machidyo/webcamera-holder/output/webcamera_holder.3mf

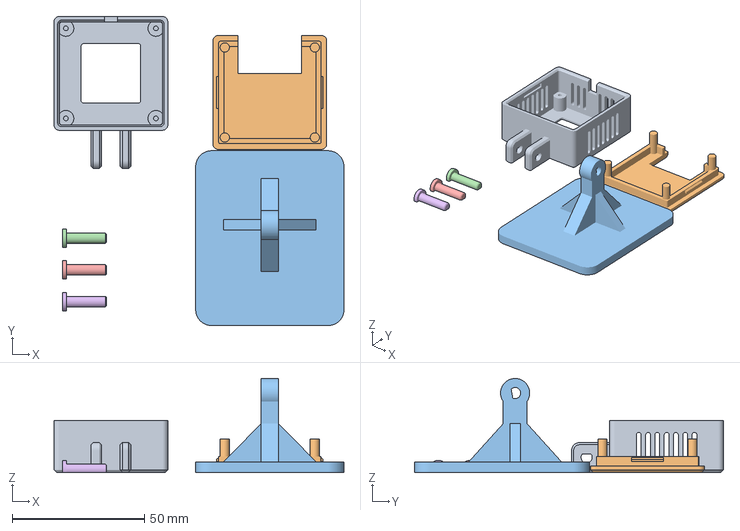
[picture p1: CAD file, 2026-11-09]
output/webcamera_holder.3mf
109.5 x 116.7 x 35.5 mm
