machidyo/webcamera-holder/output/cover.stl

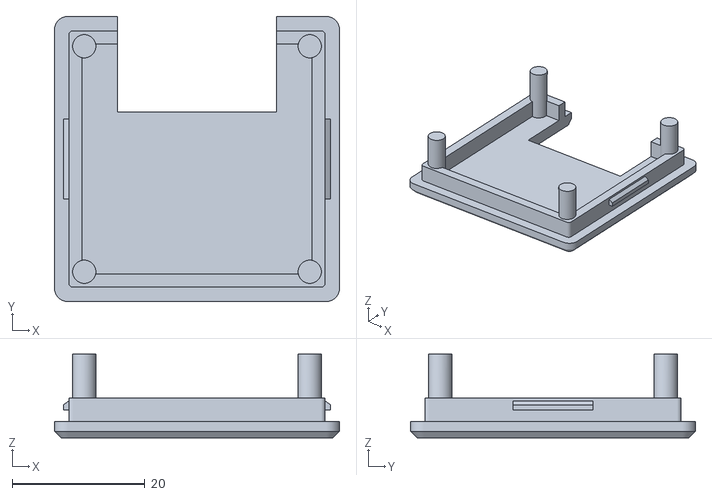
[picture p2: CAD file, 2026-11-09]
output/cover.stl
43.0 x 43.0 x 12.6
