machidyo/webcamera-holder/output/reprint_cover_pins.3mf

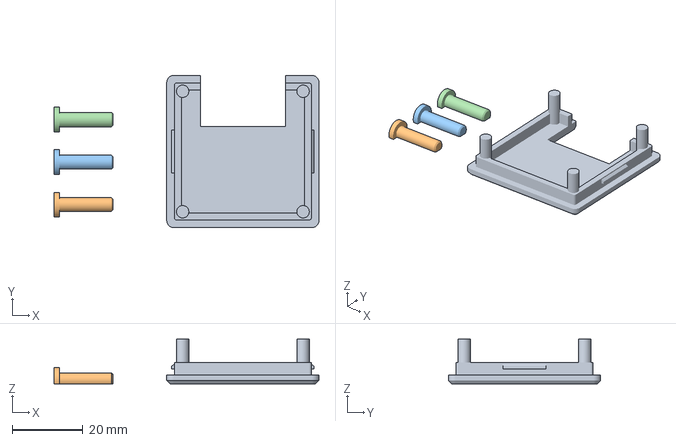
[picture p3: CAD file, 2026-11-09]
output/reprint_cover_pins.3mf
74.8 x 43.0 x 12.7 mm
