machidyo/webcamera-holder/output/stand.stl

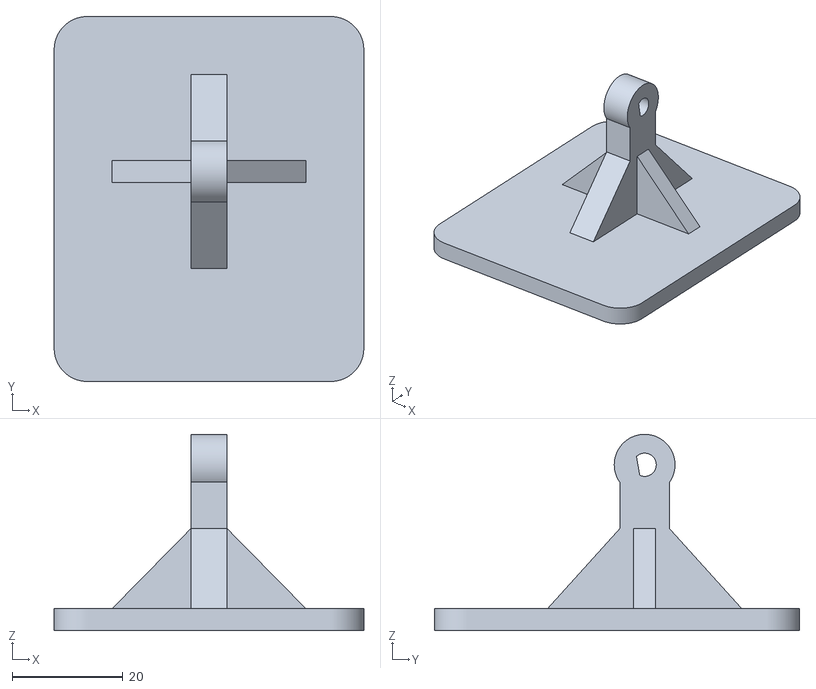
[picture p4: CAD file, 2026-11-09]
output/stand.stl
56.0 x 66.0 x 35.5
