machidyo/webcamera-holder/output/housing.stl

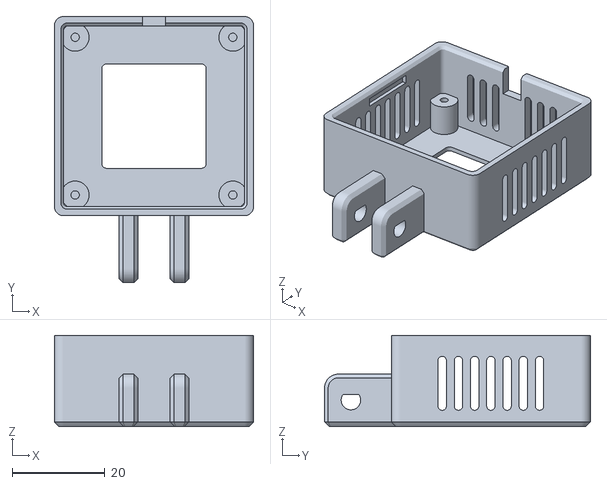
[picture p5: CAD file, 2026-10-15]
output/housing.stl
43.0 x 57.4 x 19.6
