machidyo/webcamera-holder/output/pin_4.0.stl

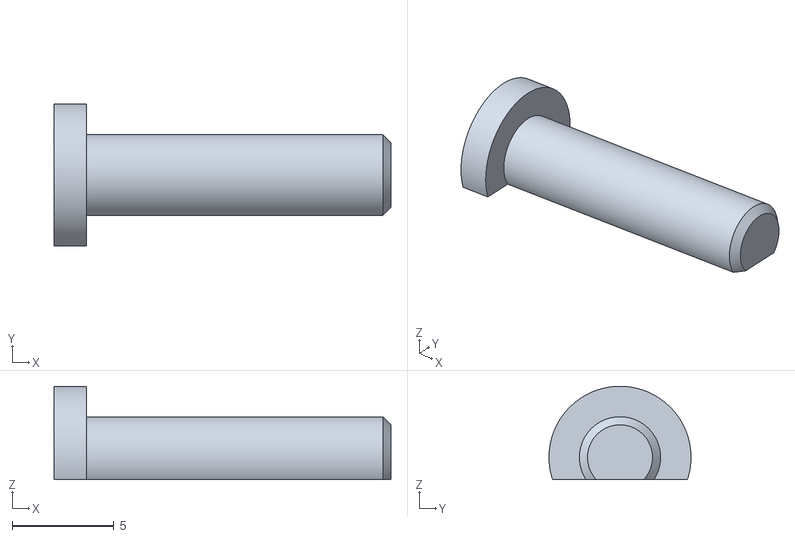
[picture p6: CAD file, 2026-10-15]
output/pin_4.0.stl
16.6 x 7.00 x 4.60
