machidyo/webcamera-holder/output/mount.stl

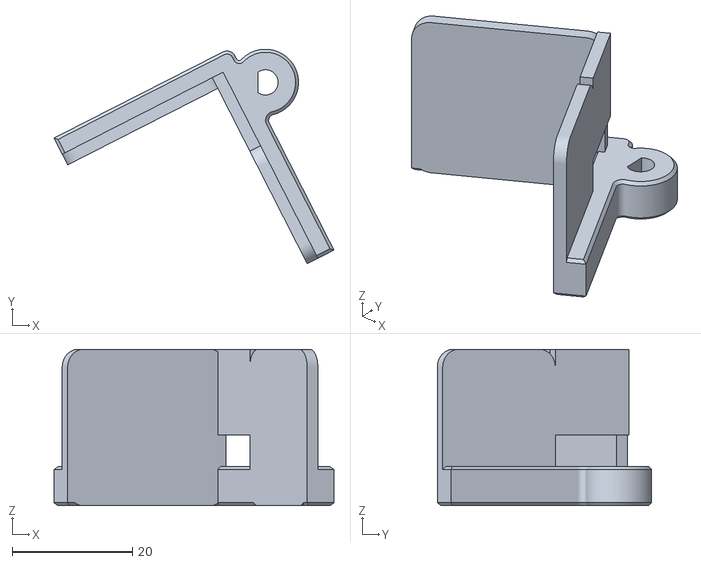
[picture p7: CAD file, 2026-10-15]
output/mount.stl
46.5 x 35.6 x 26.0
