machidyo/webcamera-holder/output/pin_4.1.stl

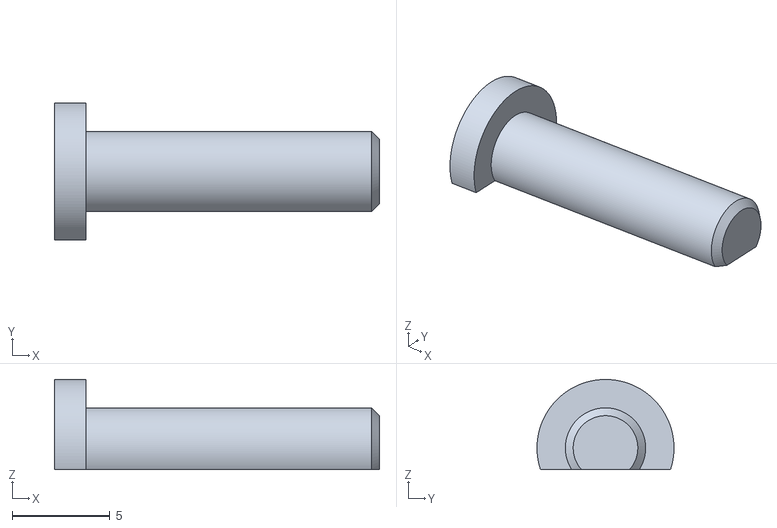
[picture p8: CAD file, 2026-10-15]
output/pin_4.1.stl
16.6 x 7.00 x 4.60
