machidyo/webcamera-holder/(list of files, cad)

Other CAD files:
output/pin_3.9.stl
