machidyo/webcamera-holder/(commit log)

2026-10-15 Add webcamera holder model and STL/3MF outputs
    [cover.stl, housing.stl, mount.stl, pin_3.9.stl, pin_4.0.stl, pin_4.1.stl, reprint_cover_pins.3mf, webcamera_holder.3mf]
2026-11-09 add: 違うカメラ無形に少し変形させて、机で使える土台を追加した
    [cover.stl, reprint_cover_pins.3mf, stand.stl, webcamera_holder.3mf]
